vapor-autos/ecu/(list of files, cad)

Other CAD files:
mech/top_case.step
pcb/ecu.3d/TYPE-C-31-M-04.STEP
pcb/ecu.3d/PCM12SMTR.STEP
pcb/ecu.3d/OS102011MA1QN1.STEP
mech/top_case.stl
