vapor-autos/ecu/(commit log)

2026-03-13 Add top case assets to lfs
    [top_case.step, top_case.stl]
2026-03-14 Remve FCStd file
    [case.FCStd]
2026-03-14 Handle STEP
    [OS102011MA1QN1.STEP, PCM12SMTR.STEP, TYPE-C-31-M-04.STEP]
2026-07-13 Zero out steering offset by default
2026-08-11 Filter Castle speed telemetry spikes (#3)
    * Filter Castle speed telemetry spikes
    * Fix speed filter formatting
    [castle.h, main.c]
2026-08-16 Reintroduce steer offset pad (#4)
    * Reintroduce steer offset pad
    * Back to int16
2026-09-10 Correct vehicle speed scaling (#5)
    [castle.h]
